osrf/ovc/ovc5/hardware/carrier/cameras.kicad_sch

## KiCad design ovc5/hardware/carrier/cameras.kicad_sch (2021-08-23)

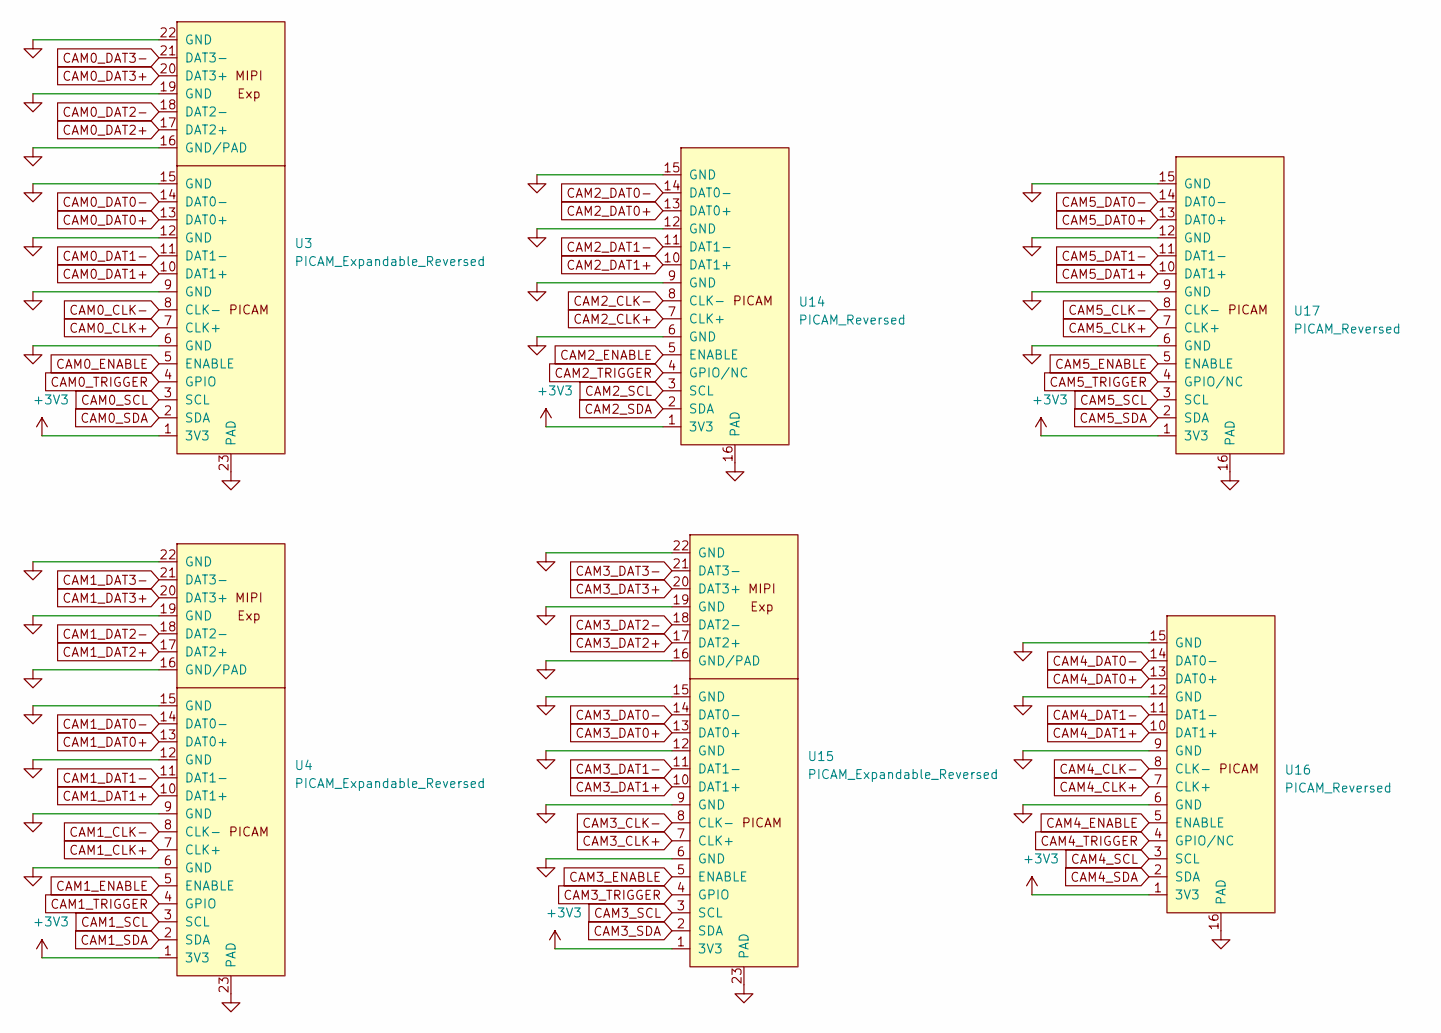
[picture p1: schematic cameras.kicad_sch]

Parts:
U3, U4, U15: PICAM_Expandable_Reversed; AMPHENOL_SFW22S; MPN SFW22S-2STE1LF
U14, U16, U17: PICAM_Reversed; AMPHENOL_SFW15S; MPN SFW15S-2STE1LF

Connections:
+3V3: U3.1 (3V3), U4.1 (3V3), U14.1 (3V3), U15.1 (3V3), U16.1 (3V3), U17.1 (3V3)
CAM0_CLK+: U3.7 (CLK+)
CAM0_CLK-: U3.8 (CLK-)
CAM0_DAT0+: U3.13 (DAT0+)
CAM0_DAT0-: U3.14 (DAT0-)
CAM0_DAT1+: U3.10 (DAT1+)
CAM0_DAT1-: U3.11 (DAT1-)
CAM0_DAT2+: U3.17 (DAT2+)
CAM0_DAT2-: U3.18 (DAT2-)
CAM0_DAT3+: U3.20 (DAT3+)
CAM0_DAT3-: U3.21 (DAT3-)
CAM0_ENABLE: U3.5 (ENABLE)
CAM0_SCL: U3.3 (SCL)
CAM0_SDA: U3.2 (SDA)
CAM0_TRIGGER: U3.4 (GPIO)
CAM1_CLK+: U4.7 (CLK+)
CAM1_CLK-: U4.8 (CLK-)
CAM1_DAT0+: U4.13 (DAT0+)
CAM1_DAT0-: U4.14 (DAT0-)
CAM1_DAT1+: U4.10 (DAT1+)
CAM1_DAT1-: U4.11 (DAT1-)
CAM1_DAT2+: U4.17 (DAT2+)
CAM1_DAT2-: U4.18 (DAT2-)
CAM1_DAT3+: U4.20 (DAT3+)
CAM1_DAT3-: U4.21 (DAT3-)
CAM1_ENABLE: U4.5 (ENABLE)
CAM1_SCL: U4.3 (SCL)
CAM1_SDA: U4.2 (SDA)
CAM1_TRIGGER: U4.4 (GPIO)
CAM2_CLK+: U14.7 (CLK+)
CAM2_CLK-: U14.8 (CLK-)
CAM2_DAT0+: U14.13 (DAT0+)
CAM2_DAT0-: U14.14 (DAT0-)
CAM2_DAT1+: U14.10 (DAT1+)
CAM2_DAT1-: U14.11 (DAT1-)
CAM2_ENABLE: U14.5 (ENABLE)
CAM2_SCL: U14.3 (SCL)
CAM2_SDA: U14.2 (SDA)
CAM2_TRIGGER: U14.4 (GPIO/NC)
CAM3_CLK+: U15.7 (CLK+)
CAM3_CLK-: U15.8 (CLK-)
CAM3_DAT0+: U15.13 (DAT0+)
CAM3_DAT0-: U15.14 (DAT0-)
CAM3_DAT1+: U15.10 (DAT1+)
CAM3_DAT1-: U15.11 (DAT1-)
CAM3_DAT2+: U15.17 (DAT2+)
CAM3_DAT2-: U15.18 (DAT2-)
CAM3_DAT3+: U15.20 (DAT3+)
CAM3_DAT3-: U15.21 (DAT3-)
CAM3_ENABLE: U15.5 (ENABLE)
CAM3_SCL: U15.3 (SCL)
CAM3_SDA: U15.2 (SDA)
CAM3_TRIGGER: U15.4 (GPIO)
CAM4_CLK+: U16.7 (CLK+)
CAM4_CLK-: U16.8 (CLK-)
CAM4_DAT0+: U16.13 (DAT0+)
CAM4_DAT0-: U16.14 (DAT0-)
CAM4_DAT1+: U16.10 (DAT1+)
CAM4_DAT1-: U16.11 (DAT1-)
CAM4_ENABLE: U16.5 (ENABLE)
CAM4_SCL: U16.3 (SCL)
CAM4_SDA: U16.2 (SDA)
CAM4_TRIGGER: U16.4 (GPIO/NC)
CAM5_CLK+: U17.7 (CLK+)
CAM5_CLK-: U17.8 (CLK-)
CAM5_DAT0+: U17.13 (DAT0+)
CAM5_DAT0-: U17.14 (DAT0-)
CAM5_DAT1+: U17.10 (DAT1+)
CAM5_DAT1-: U17.11 (DAT1-)
CAM5_ENABLE: U17.5 (ENABLE)
CAM5_SCL: U17.3 (SCL)
CAM5_SDA: U17.2 (SDA)
CAM5_TRIGGER: U17.4 (GPIO/NC)
GND: U3.6 (GND), U3.9 (GND), U3.12 (GND), U3.15 (GND), U3.16 (GND/PAD), U3.19 (GND), U3.22 (GND), U3.23 (PAD), U4.6 (GND), U4.9 (GND), U4.12 (GND), U4.15 (GND), U4.16 (GND/PAD), U4.19 (GND), U4.22 (GND), U4.23 (PAD), U14.6 (GND), U14.9 (GND), U14.12 (GND), U14.15 (GND), U14.16 (PAD), U15.6 (GND), U15.9 (GND), U15.12 (GND), U15.15 (GND), U15.16 (GND/PAD), U15.19 (GND), U15.22 (GND), U15.23 (PAD), U16.6 (GND), U16.9 (GND), U16.12 (GND), U16.15 (GND), U16.16 (PAD), U17.6 (GND), U17.9 (GND), U17.12 (GND), U17.15 (GND), U17.16 (PAD)
