osrf/ovc/ovc5/hardware/carrier/enclustra_module.kicad_sch

## KiCad design ovc5/hardware/carrier/enclustra_module.kicad_sch (2021-08-23)

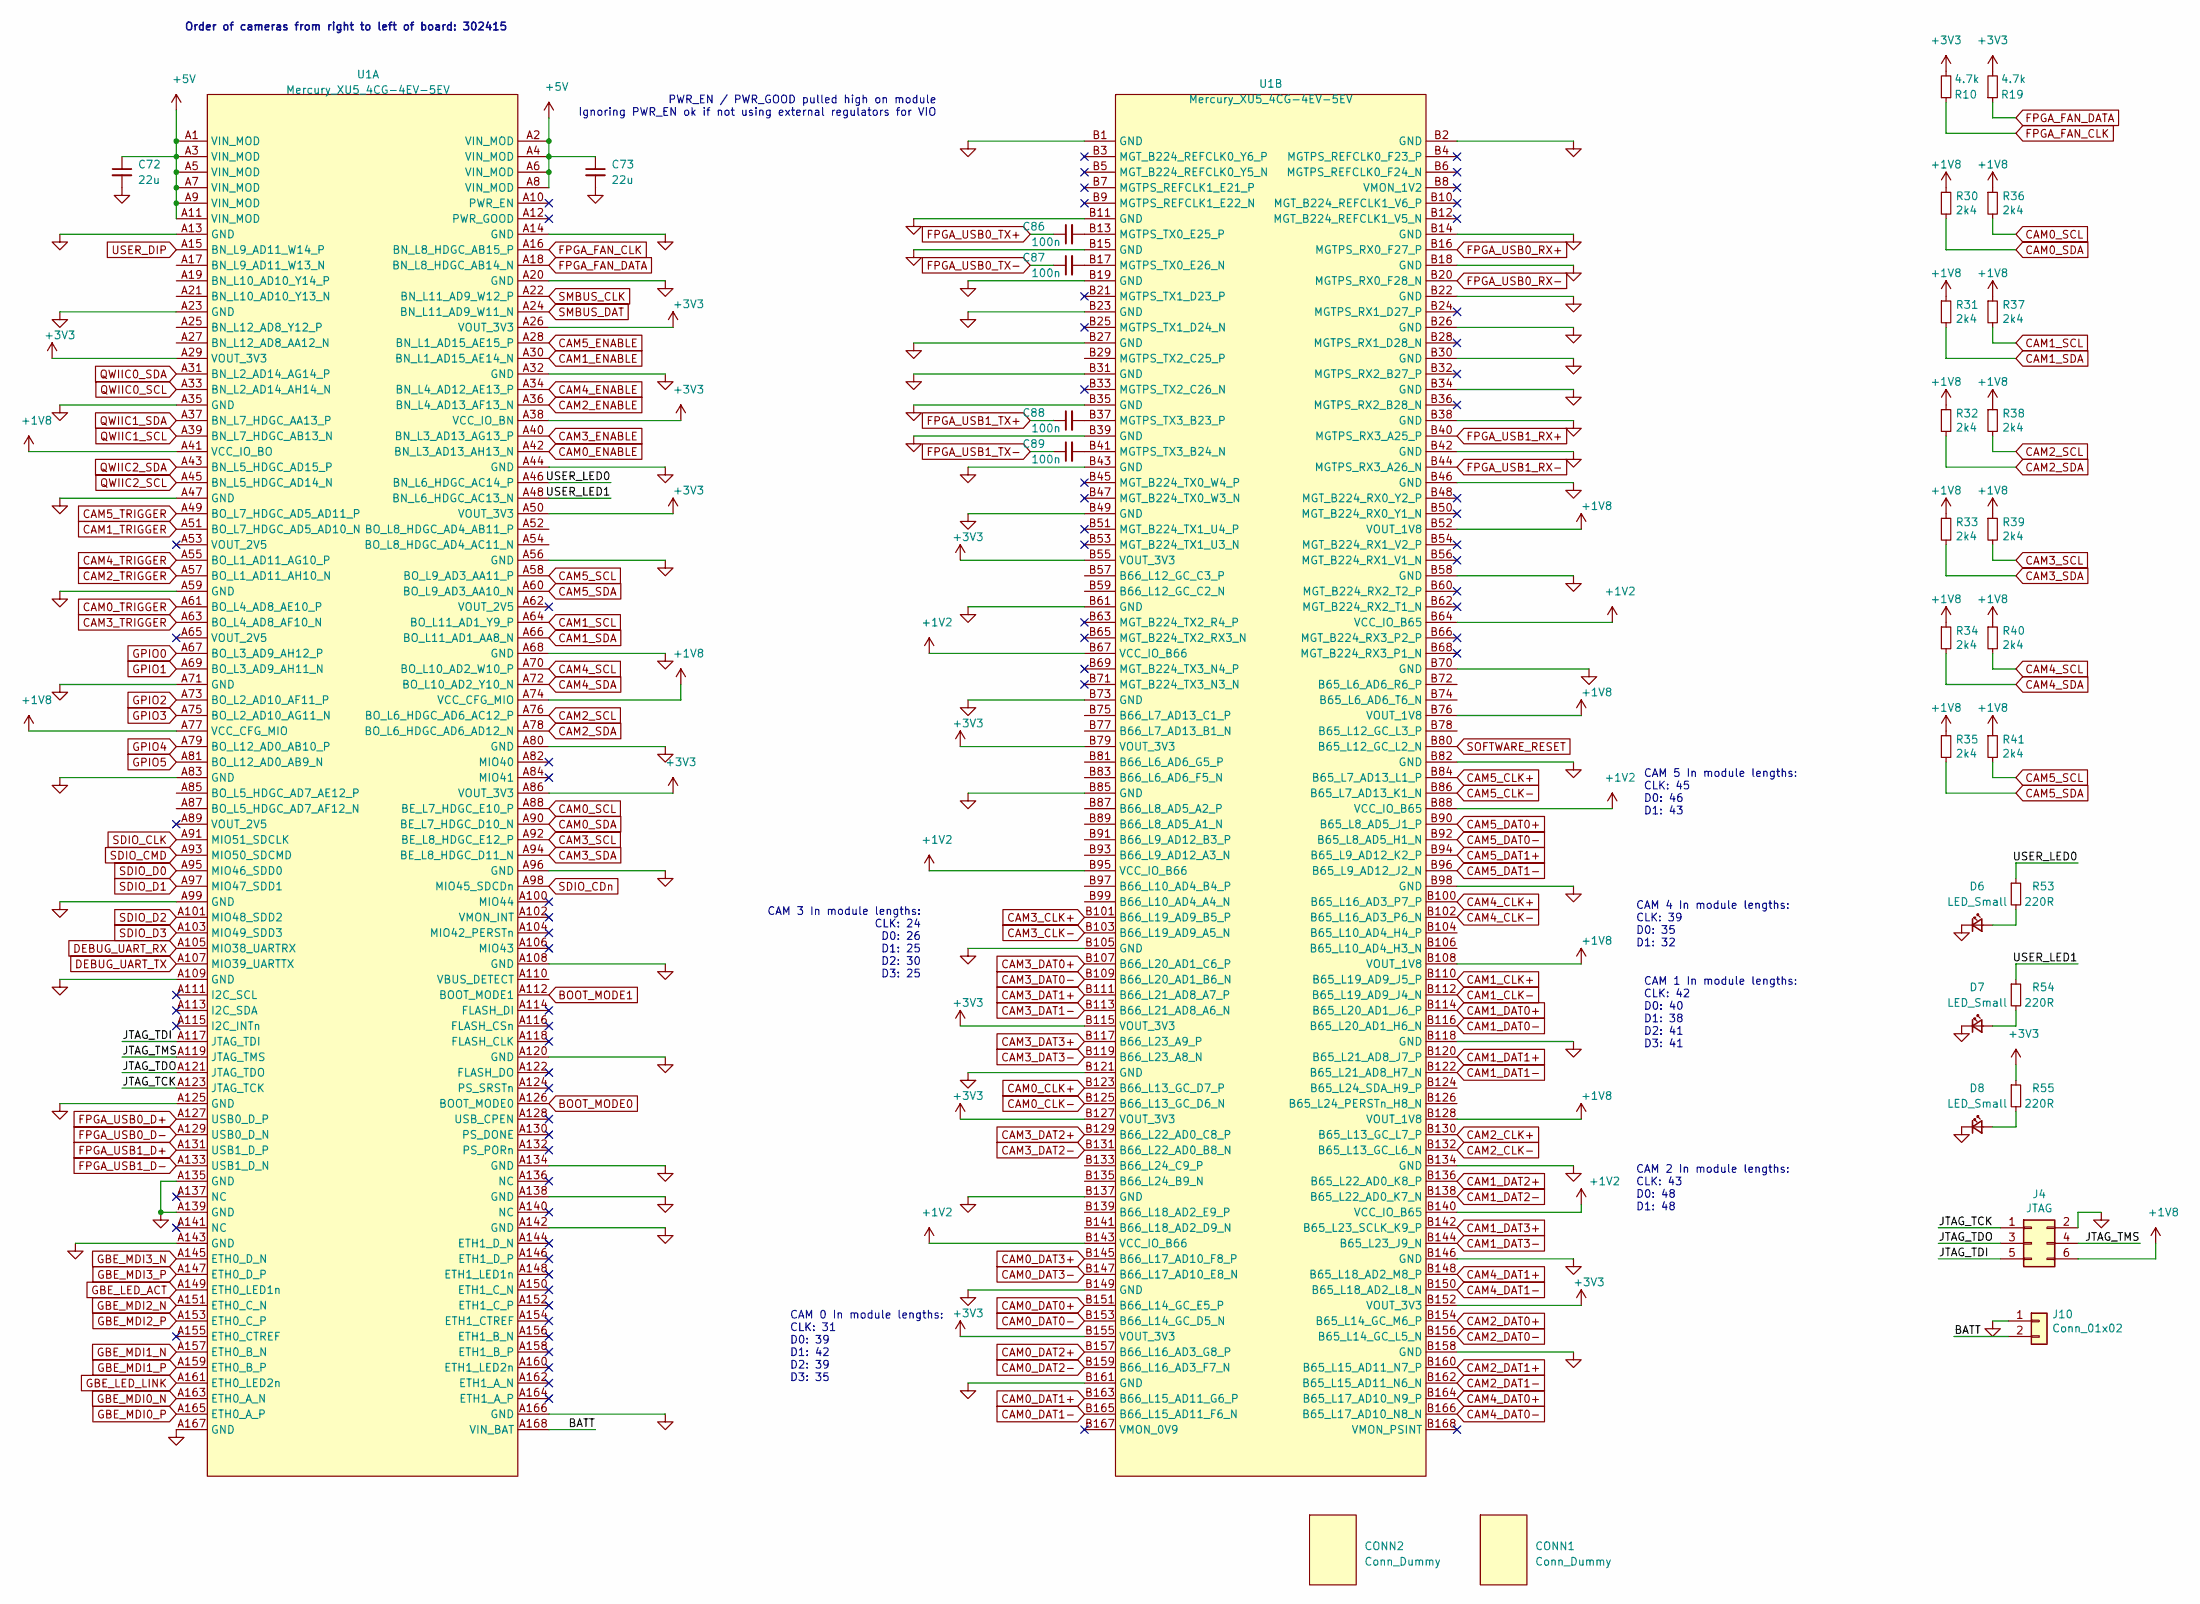
[picture p2: schematic enclustra_module.kicad_sch]

Parts:
C72, C73: 22u; C_0603_1608Metric; MPN CL10A226MPCNUBE
C86, C87, C88, C89: 100n; C_0201_0603Metric; MPN 0201X104K160CT
CONN1, CONN2: Conn_Dummy; MPN FX10A-168P-SV(71)
D6: LED_Small; LED_0402_1005Metric; MPN LB QH9G-N1OO-35-1
D7: LED_Small; LED_0402_1005Metric; MPN LR VH9F-P2R1-1-Z
D8: LED_Small; LED_0402_1005Metric; MPN LT VH9G-Q2OO-25-1
J4: JTAG; PinHeader_2x03_P2.54mm_Vertical; MPN PR20203VBDN
J10: Conn_01x02; ELNA_DSK-3R3H224U-HL; MPN DSK-3R3H224U-HL
R10, R19: 4.7k; R_0402_1005Metric; MPN ERJ-PA2F4701X
R30, R31, R32, R33, R34, R35, R36, R37, R38, R39, R40, R41: 2k4; R_0402_1005Metric; MPN ERA-2AED242X
R53, R54, R55: 220R; R_0402_1005Metric; MPN RCS0402220RFKED
U1: Mercury_XU5_4CG-4EV-5EV; Mercury_XU5; MPN DNP

Connections:
+1V2: U1.B64 (VCC_IO_B65), U1.B67 (VCC_IO_B66), U1.B88 (VCC_IO_B65), U1.B95 (VCC_IO_B66), U1.B140 (VCC_IO_B65), U1.B143 (VCC_IO_B66)
+1V8: J4.6, R30.1, R31.1, R32.1, R33.1, R34.1, R35.1, R36.1, R37.1, R38.1, R39.1, R40.1, R41.1, U1.A41 (VCC_IO_BO), U1.A74 (VCC_CFG_MIO), U1.A77 (VCC_CFG_MIO), U1.B52 (VOUT_1V8), U1.B76 (VOUT_1V8), U1.B108 (VOUT_1V8), U1.B128 (VOUT_1V8)
+3V3: R10.2, R19.2, R55.1, U1.A26 (VOUT_3V3), U1.A29 (VOUT_3V3), U1.A38 (VCC_IO_BN), U1.A50 (VOUT_3V3), U1.A86 (VOUT_3V3), U1.B55 (VOUT_3V3), U1.B79 (VOUT_3V3), U1.B115 (VOUT_3V3), U1.B127 (VOUT_3V3), U1.B152 (VOUT_3V3), U1.B155 (VOUT_3V3)
+5V: C72.1, C73.1, U1.A1 (VIN_MOD), U1.A2 (VIN_MOD), U1.A3 (VIN_MOD), U1.A4 (VIN_MOD), U1.A5 (VIN_MOD), U1.A6 (VIN_MOD), U1.A7 (VIN_MOD), U1.A8 (VIN_MOD), U1.A9 (VIN_MOD), U1.A11 (VIN_MOD)
BATT: J10.2, U1.A168 (VIN_BAT)
BOOT_MODE0: U1.A126 (BOOT_MODE0)
BOOT_MODE1: U1.A112 (BOOT_MODE1)
CAM0_CLK+: U1.B123 (B66_L13_GC_D7_P)
CAM0_CLK-: U1.B125 (B66_L13_GC_D6_N)
CAM0_DAT0+: U1.B151 (B66_L14_GC_E5_P)
CAM0_DAT0-: U1.B153 (B66_L14_GC_D5_N)
CAM0_DAT1+: U1.B163 (B66_L15_AD11_G6_P)
CAM0_DAT1-: U1.B165 (B66_L15_AD11_F6_N)
CAM0_DAT2+: U1.B157 (B66_L16_AD3_G8_P)
CAM0_DAT2-: U1.B159 (B66_L16_AD3_F7_N)
CAM0_DAT3+: U1.B145 (B66_L17_AD10_F8_P)
CAM0_DAT3-: U1.B147 (B66_L17_AD10_E8_N)
CAM0_ENABLE: U1.A42 (BN_L3_AD13_AH13_N)
CAM0_SCL: R36.2, U1.A88 (BE_L7_HDGC_E10_P)
CAM0_SDA: R30.2, U1.A90 (BE_L7_HDGC_D10_N)
CAM0_TRIGGER: U1.A61 (BO_L4_AD8_AE10_P)
CAM1_CLK+: U1.B110 (B65_L19_AD9_J5_P)
CAM1_CLK-: U1.B112 (B65_L19_AD9_J4_N)
CAM1_DAT0+: U1.B114 (B65_L20_AD1_J6_P)
CAM1_DAT0-: U1.B116 (B65_L20_AD1_H6_N)
CAM1_DAT1+: U1.B120 (B65_L21_AD8_J7_P)
CAM1_DAT1-: U1.B122 (B65_L21_AD8_H7_N)
CAM1_DAT2+: U1.B136 (B65_L22_AD0_K8_P)
CAM1_DAT2-: U1.B138 (B65_L22_AD0_K7_N)
CAM1_DAT3+: U1.B142 (B65_L23_SCLK_K9_P)
CAM1_DAT3-: U1.B144 (B65_L23_J9_N)
CAM1_ENABLE: U1.A30 (BN_L1_AD15_AE14_N)
CAM1_SCL: R37.2, U1.A64 (BO_L11_AD1_Y9_P)
CAM1_SDA: R31.2, U1.A66 (BO_L11_AD1_AA8_N)
CAM1_TRIGGER: U1.A51 (BO_L7_HDGC_AD5_AD10_N)
CAM2_CLK+: U1.B130 (B65_L13_GC_L7_P)
CAM2_CLK-: U1.B132 (B65_L13_GC_L6_N)
CAM2_DAT0+: U1.B154 (B65_L14_GC_M6_P)
CAM2_DAT0-: U1.B156 (B65_L14_GC_L5_N)
CAM2_DAT1+: U1.B160 (B65_L15_AD11_N7_P)
CAM2_DAT1-: U1.B162 (B65_L15_AD11_N6_N)
CAM2_ENABLE: U1.A36 (BN_L4_AD13_AF13_N)
CAM2_SCL: R38.2, U1.A76 (BO_L6_HDGC_AD6_AC12_P)
CAM2_SDA: R32.2, U1.A78 (BO_L6_HDGC_AD6_AD12_N)
CAM2_TRIGGER: U1.A57 (BO_L1_AD11_AH10_N)
CAM3_CLK+: U1.B101 (B66_L19_AD9_B5_P)
CAM3_CLK-: U1.B103 (B66_L19_AD9_A5_N)
CAM3_DAT0+: U1.B107 (B66_L20_AD1_C6_P)
CAM3_DAT0-: U1.B109 (B66_L20_AD1_B6_N)
CAM3_DAT1+: U1.B111 (B66_L21_AD8_A7_P)
CAM3_DAT1-: U1.B113 (B66_L21_AD8_A6_N)
CAM3_DAT2+: U1.B129 (B66_L22_AD0_C8_P)
CAM3_DAT2-: U1.B131 (B66_L22_AD0_B8_N)
CAM3_DAT3+: U1.B117 (B66_L23_A9_P)
CAM3_DAT3-: U1.B119 (B66_L23_A8_N)
CAM3_ENABLE: U1.A40 (BN_L3_AD13_AG13_P)
CAM3_SCL: R39.2, U1.A92 (BE_L8_HDGC_E12_P)
CAM3_SDA: R33.2, U1.A94 (BE_L8_HDGC_D11_N)
CAM3_TRIGGER: U1.A63 (BO_L4_AD8_AF10_N)
CAM4_CLK+: U1.B100 (B65_L16_AD3_P7_P)
CAM4_CLK-: U1.B102 (B65_L16_AD3_P6_N)
CAM4_DAT0+: U1.B164 (B65_L17_AD10_N9_P)
CAM4_DAT0-: U1.B166 (B65_L17_AD10_N8_N)
CAM4_DAT1+: U1.B148 (B65_L18_AD2_M8_P)
CAM4_DAT1-: U1.B150 (B65_L18_AD2_L8_N)
CAM4_ENABLE: U1.A34 (BN_L4_AD12_AE13_P)
CAM4_SCL: R40.2, U1.A70 (BO_L10_AD2_W10_P)
CAM4_SDA: R34.2, U1.A72 (BO_L10_AD2_Y10_N)
CAM4_TRIGGER: U1.A55 (BO_L1_AD11_AG10_P)
CAM5_CLK+: U1.B84 (B65_L7_AD13_L1_P)
CAM5_CLK-: U1.B86 (B65_L7_AD13_K1_N)
CAM5_DAT0+: U1.B90 (B65_L8_AD5_J1_P)
CAM5_DAT0-: U1.B92 (B65_L8_AD5_H1_N)
CAM5_DAT1+: U1.B94 (B65_L9_AD12_K2_P)
CAM5_DAT1-: U1.B96 (B65_L9_AD12_J2_N)
CAM5_ENABLE: U1.A28 (BN_L1_AD15_AE15_P)
CAM5_SCL: R41.2, U1.A58 (BO_L9_AD3_AA11_P)
CAM5_SDA: R35.2, U1.A60 (BO_L9_AD3_AA10_N)
CAM5_TRIGGER: U1.A49 (BO_L7_HDGC_AD5_AD11_P)
DEBUG_UART_RX: U1.A105 (MIO38_UARTRX)
DEBUG_UART_TX: U1.A107 (MIO39_UARTTX)
FPGA_FAN_CLK: R10.1, U1.A16 (BN_L8_HDGC_AB15_P)
FPGA_FAN_DATA: R19.1, U1.A18 (BN_L8_HDGC_AB14_N)
FPGA_USB0_D+: U1.A127 (USB0_D_P)
FPGA_USB0_D-: U1.A129 (USB0_D_N)
FPGA_USB0_RX+: U1.B16 (MGTPS_RX0_F27_P)
FPGA_USB0_RX-: U1.B20 (MGTPS_RX0_F28_N)
FPGA_USB0_TX+: C86.1
FPGA_USB0_TX-: C87.1
FPGA_USB1_D+: U1.A131 (USB1_D_P)
FPGA_USB1_D-: U1.A133 (USB1_D_N)
FPGA_USB1_RX+: U1.B40 (MGTPS_RX3_A25_P)
FPGA_USB1_RX-: U1.B44 (MGTPS_RX3_A26_N)
FPGA_USB1_TX+: C88.1
FPGA_USB1_TX-: C89.1
GBE_LED_ACT: U1.A149 (ETH0_LED1n)
GBE_LED_LINK: U1.A161 (ETH0_LED2n)
GBE_MDI0_N: U1.A163 (ETH0_A_N)
GBE_MDI0_P: U1.A165 (ETH0_A_P)
GBE_MDI1_N: U1.A157 (ETH0_B_N)
GBE_MDI1_P: U1.A159 (ETH0_B_P)
GBE_MDI2_N: U1.A151 (ETH0_C_N)
GBE_MDI2_P: U1.A153 (ETH0_C_P)
GBE_MDI3_N: U1.A145 (ETH0_D_N)
GBE_MDI3_P: U1.A147 (ETH0_D_P)
GND: C72.2, C73.2, D6.1 (K), D7.1 (K), D8.1 (K), J4.2, J10.1, U1.A13 (GND), U1.A14 (GND), U1.A20 (GND), U1.A23 (GND), U1.A32 (GND), U1.A35 (GND), U1.A44 (GND), U1.A47 (GND), U1.A56 (GND), U1.A59 (GND), U1.A68 (GND), U1.A71 (GND), U1.A80 (GND), U1.A83 (GND), U1.A96 (GND), U1.A99 (GND), U1.A108 (GND), U1.A109 (GND), U1.A120 (GND), U1.A125 (GND), U1.A134 (GND), U1.A135 (GND), U1.A138 (GND), U1.A139 (GND), U1.A142 (GND), U1.A143 (GND), U1.A166 (GND), U1.A167 (GND), U1.B1 (GND), U1.B2 (GND), U1.B11 (GND), U1.B14 (GND), U1.B15 (GND), U1.B18 (GND), U1.B19 (GND), U1.B22 (GND), U1.B23 (GND), U1.B26 (GND), U1.B27 (GND), U1.B30 (GND), U1.B31 (GND), U1.B34 (GND), U1.B35 (GND), U1.B38 (GND), U1.B39 (GND), U1.B42 (GND), U1.B43 (GND), U1.B46 (GND), U1.B49 (GND), U1.B58 (GND), U1.B61 (GND), U1.B70 (GND), U1.B73 (GND), U1.B82 (GND), U1.B85 (GND), U1.B98 (GND), U1.B105 (GND), U1.B118 (GND), U1.B121 (GND), U1.B134 (GND), U1.B137 (GND), U1.B146 (GND), U1.B149 (GND), U1.B158 (GND), U1.B161 (GND)
GPIO0: U1.A67 (BO_L3_AD9_AH12_P)
GPIO1: U1.A69 (BO_L3_AD9_AH11_N)
GPIO2: U1.A73 (BO_L2_AD10_AF11_P)
GPIO3: U1.A75 (BO_L2_AD10_AG11_N)
GPIO4: U1.A79 (BO_L12_AD0_AB10_P)
GPIO5: U1.A81 (BO_L12_AD0_AB9_N)
JTAG_TCK: J4.1, U1.A123 (JTAG_TCK)
JTAG_TDI: J4.5, U1.A117 (JTAG_TDI)
JTAG_TDO: J4.3, U1.A121 (JTAG_TDO)
JTAG_TMS: J4.4, U1.A119 (JTAG_TMS)
unnamed: C86.2, U1.B13 (MGTPS_TX0_E25_P)
unnamed: C87.2, U1.B17 (MGTPS_TX0_E26_N)
unnamed: C88.2, U1.B37 (MGTPS_TX3_B23_P)
unnamed: C89.2, U1.B41 (MGTPS_TX3_B24_N)
unnamed: D6.2 (A), R53.2
unnamed: D7.2 (A), R54.2
unnamed: D8.2 (A), R55.2
QWIIC0_SCL: U1.A33 (BN_L2_AD14_AH14_N)
QWIIC0_SDA: U1.A31 (BN_L2_AD14_AG14_P)
QWIIC1_SCL: U1.A39 (BN_L7_HDGC_AB13_N)
QWIIC1_SDA: U1.A37 (BN_L7_HDGC_AA13_P)
QWIIC2_SCL: U1.A45 (BN_L5_HDGC_AD14_N)
QWIIC2_SDA: U1.A43 (BN_L5_HDGC_AD15_P)
SDIO_CDn: U1.A98 (MIO45_SDCDn)
SDIO_CLK: U1.A91 (MIO51_SDCLK)
SDIO_CMD: U1.A93 (MIO50_SDCMD)
SDIO_D0: U1.A95 (MIO46_SDD0)
SDIO_D1: U1.A97 (MIO47_SDD1)
SDIO_D2: U1.A101 (MIO48_SDD2)
SDIO_D3: U1.A103 (MIO49_SDD3)
SMBUS_CLK: U1.A22 (BN_L11_AD9_W12_P)
SMBUS_DAT: U1.A24 (BN_L11_AD9_W11_N)
SOFTWARE_RESET: U1.B80 (B65_L12_GC_L2_N)
USER_DIP: U1.A15 (BN_L9_AD11_W14_P)
USER_LED0: R53.1, U1.A46 (BN_L6_HDGC_AC14_P)
USER_LED1: R54.1, U1.A48 (BN_L6_HDGC_AC13_N)

Notes on the sheet:
Order of cameras from right to left of board: 302415
CAM 0 In module lengths: CLK: 31 D0: 39 D1: 42 D2: 39 D3: 35
CAM 3 In module lengths: CLK: 24 D0: 26 D1: 25 D2: 30 D3: 25
PWR_EN / PWR_GOOD pulled high on module Ignoring PWR_EN ok if not using external regulators for VIO
CAM 4 In module lengths: CLK: 39 D0: 35 D1: 32
CAM 2 In module lengths: CLK: 43 D0: 48 D1: 48
CAM 5 In module lengths: CLK: 45 D0: 46 D1: 43
CAM 1 In module lengths: CLK: 42 D0: 40 D1: 38 D2: 41 D3: 41
