osrf/ovc/ovc5/hardware/carrier/ovc5.kicad_sch

## KiCad design ovc5/hardware/carrier/ovc5.kicad_sch (2021-08-23)

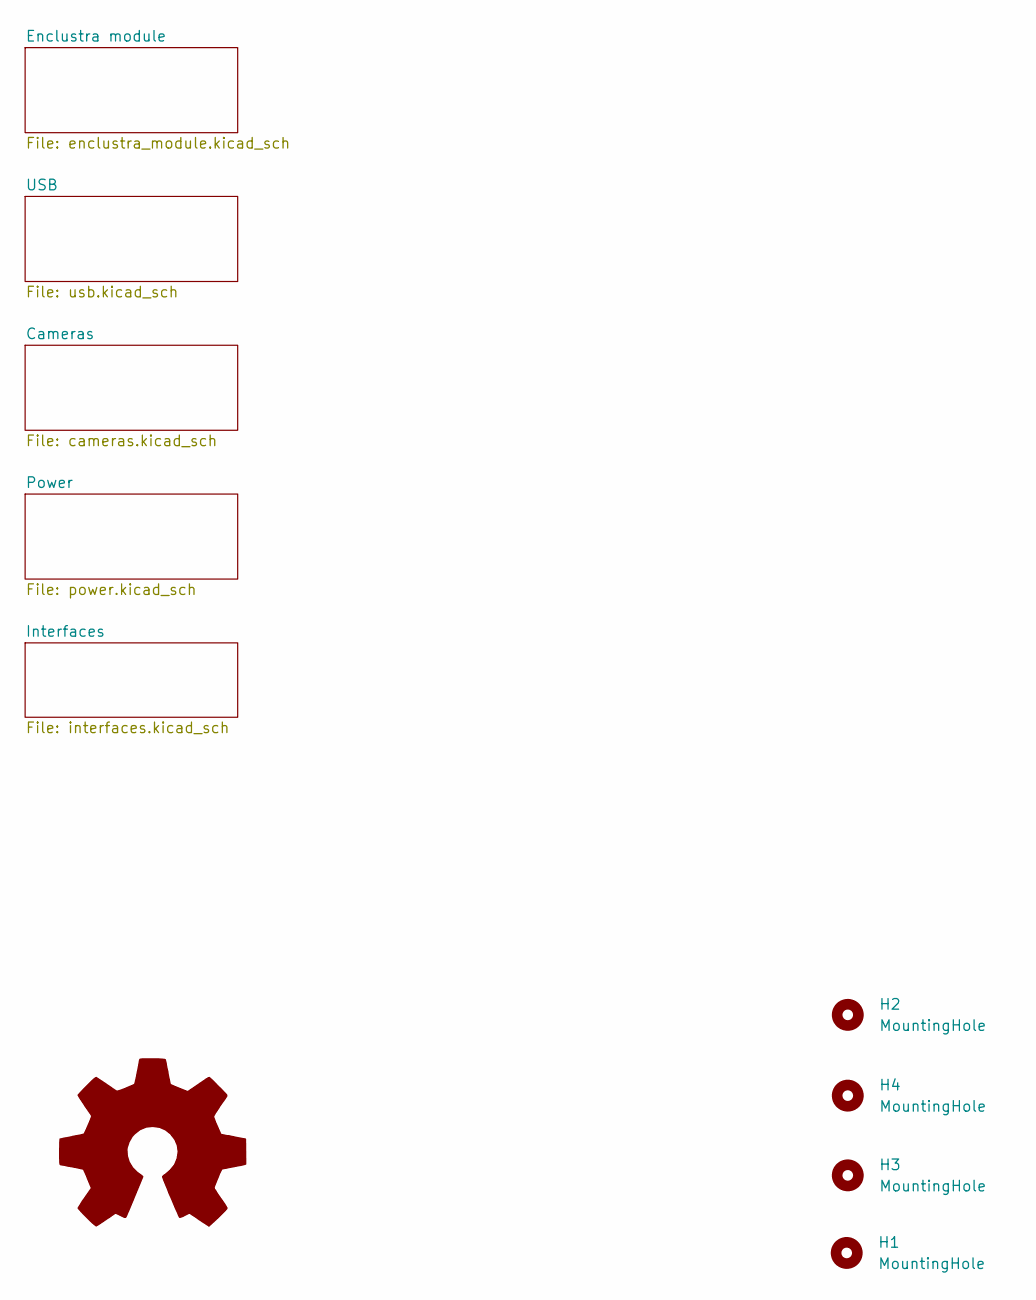
[picture p4: schematic ovc5.kicad_sch]

Parts:
H1, H2, H3, H4: MountingHole; MountingHole_3.2mm_M3; MPN DNF
LOGO1: Logo_Open_Hardware_Large; OSHW-Symbol_13.4x12mm_SilkScreen; MPN DNP
