osrf/ovc/ovc5/hardware/carrier/power.kicad_sch

## KiCad design ovc5/hardware/carrier/power.kicad_sch (2021-08-23)

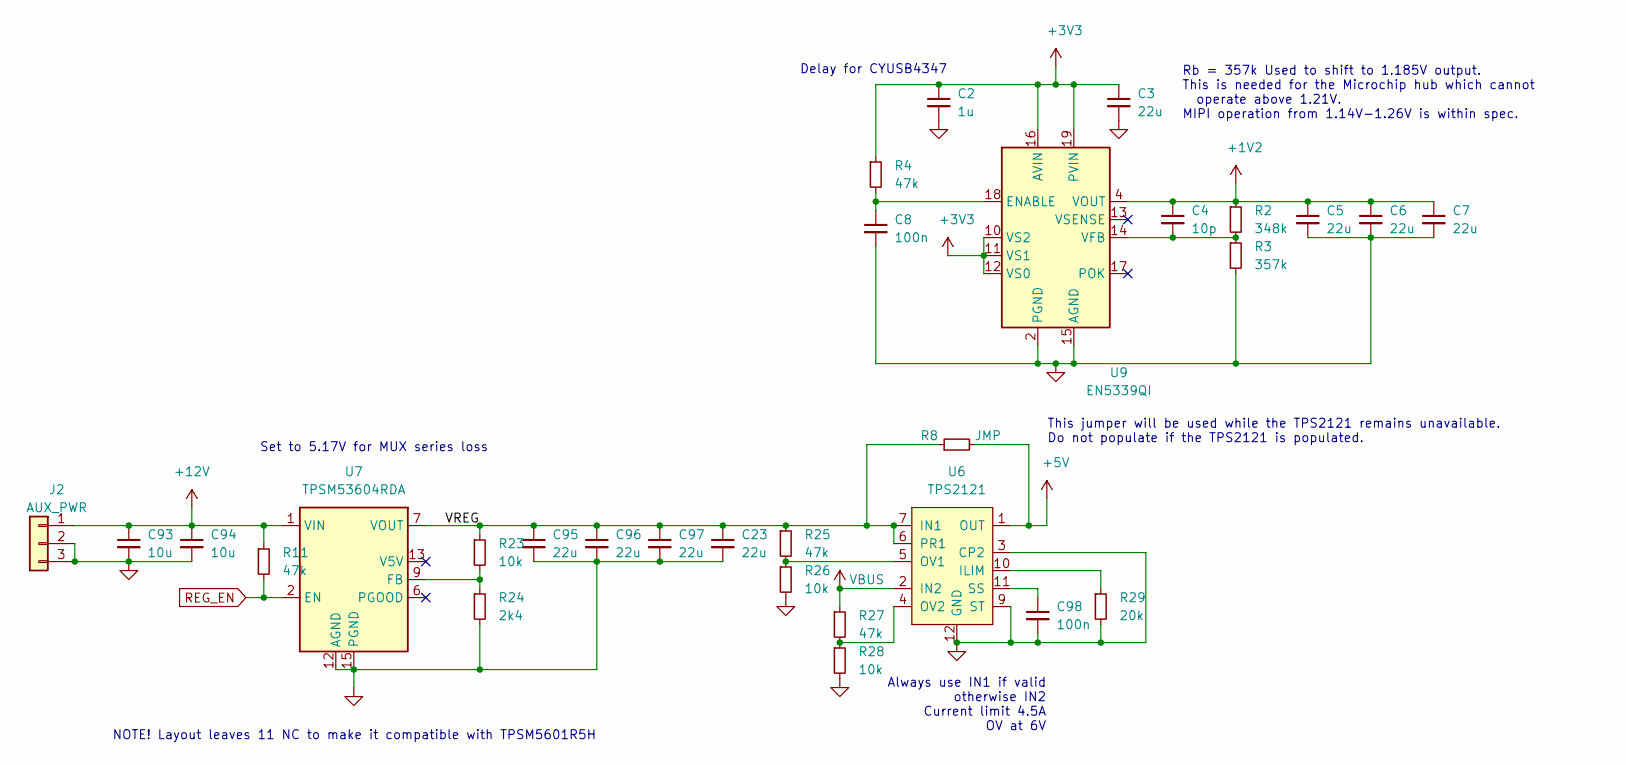
[picture p5: schematic power.kicad_sch]

Parts:
C2: 1u; C_0402_1005Metric; MPN CL05A105KP5NNNC
C3, C5, C6, C7, C23, C95, C96, C97: 22u; C_0603_1608Metric; MPN CL10A226MPCNUBE
C4: 10p; C_0402_1005Metric; MPN UMK105CG100DV-F
C8, C98: 100n; C_0201_0603Metric; MPN 0201X104K160CT
C93, C94: 10u; C_1206_3216Metric; MPN CL31A106MBHNNNE
J2: AUX_PWR; BarrelJack_CUI_PJ-102AH_Horizontal; MPN PJ-102AH
R2: 348k; R_0402_1005Metric; MPN RK73H1ETTP3483F
R3: 357k; R_0402_1005Metric; MPN RC0402FR-07357KL
R4, R11, R25, R27: 47k; R_0402_1005Metric; MPN RC0402FR-0747KL
R8: JMP; R_0603_1608Metric; MPN CRCW06030000Z0EAHP
R23, R26, R28: 10k; R_0402_1005Metric; MPN AC0402FR-0710KL
R24: 2k4; R_0402_1005Metric; MPN ERA-2AED242X
R29: 20k; R_0402_1005Metric; MPN RC0402FR-0720KL
U6: TPS2121; Texas_VQFN-HR-12_2x2.5_Pitch0.5mm; MPN TPS2121RUXR
U7: TPSM53604RDA; Texas_B3QFN-14-1EP_5x5.5mm_P0.65mm_ThermalVia; MPN TPSM53604RDAR
U9: EN5339QI; Converter_DCDC_Intel_QFN-24_4x6mm_P0.65mm_ThermalVias; MPN EN5339QI

Connections:
+1V2: C4.1, C5.1, C6.1, C7.1, R2.1, U9.4 (VOUT), U9.5 (VOUT), U9.6 (VOUT), U9.7 (VOUT)
+3V3: C2.1, C3.1, R4.1, U9.10 (VS2), U9.11 (VS1), U9.12 (VS0), U9.16 (AVIN), U9.19 (PVIN), U9.20 (PVIN)
+5V: R8.2, U6.1 (OUT), U6.8 (OUT)
+12V: C93.1, C94.1, J2.1, R11.1, U7.1 (VIN), U7.14 (VIN)
GND: C2.2, C3.2, C5.2, C6.2, C7.2, C8.2, C23.2, C93.2, C94.2, C95.2, C96.2, C97.2, C98.2, J2.2, J2.3, R3.2, R24.2, R26.2, R28.2, R29.2, U6.3 (CP2), U6.9 (ST), U6.12 (GND), U7.3 (PGND), U7.10 (PGND), U7.11 (PGND), U7.12 (AGND), U7.15 (PGND), U9.2 (PGND), U9.3 (PGND), U9.8 (PGND), U9.9 (PGND), U9.15 (AGND), U9.25 (PGND)
unnamed: C4.2, R2.2, R3.1, U9.14 (VFB)
unnamed: C8.1, R4.2, U9.18 (ENABLE)
unnamed: C98.1, U6.11 (SS)
unnamed: R23.2, R24.1, U7.9 (FB)
unnamed: R25.2, R26.1, U6.5 (OV1)
unnamed: R27.2, R28.1, U6.4 (OV2)
unnamed: R29.1, U6.10 (ILIM)
REG_EN: R11.2, U7.2 (EN)
VBUS: R27.1, U6.2 (IN2)
VREG: C23.1, C95.1, C96.1, C97.1, R8.1, R23.1, R25.1, U6.6 (PR1), U6.7 (IN1), U7.7 (VOUT), U7.8 (VOUT)

Notes on the sheet:
Set to 5.17V for MUX series loss
NOTE! Layout leaves 11 NC to make it compatible with TPSM5601R5H
Delay for CYUSB4347
This jumper will be used while the TPS2121 remains unavailable. Do not populate if the TPS2121 is populated.
Always use IN1 if valid otherwise IN2 Current limit 4.5A OV at 6V
Rb = 357k Used to shift to 1.185V output. This is needed for the Microchip hub which cannot operate above 1.21V. MIPI operation from 1.14V-1.26V is within spec.
